vidurawarna/EN2090_Project_LPS/Images/Oscilloscope/2022_03_28/Note.txt

>> We implemented the circuit on a dot board to test high currents.
>> 1-1ohm means 1.1ohms in the video names
