vidurawarna/EN2090_Project_LPS/Documents/Block Level Designs-nifla.docx

Block Level Designs

The main blocks of a linear power supply are as follows,

We are given a 230V to 15V transformer the peak value of the secondary winding V_(PSec) is around 21.2V. We are using full-wave bridge rectification for the rectification. Here we should consider the Peak-Inverse-Voltage (PIV) of each diode. Since the reverse-biased voltage can go up to ( V_(pSec) -0.7)V (Here we assume forward biased voltage across a diode as 0.7V . Since it can vary, we should double-check diodes before assuming such voltages), the diodes we choose should have a PIV above 19.5V .

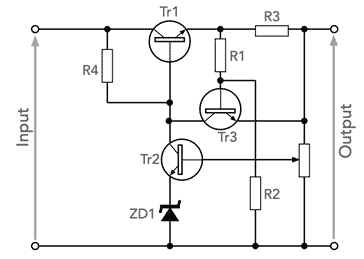
[picture p15: figure]

Next, we may use smoothing capacitors to smooth the voltage and reduce the ripple factor. Ripple voltage can be calculated from the following equation,

V_(ripple) =(I_(load))/(2fC)

Since we have a rectified voltage wave at this point, we can regulate it and get a good DC output at the load. We can consider the current limiting of the circuit here and have circuitry for regulation with current limiting as to the figure shows.

We can limit the maximum current by the equation,

I_(max) =1/(R_3)((1+(R_1)/(R_2))V_(BE) +(R_1)/(R_2)V_(reg)

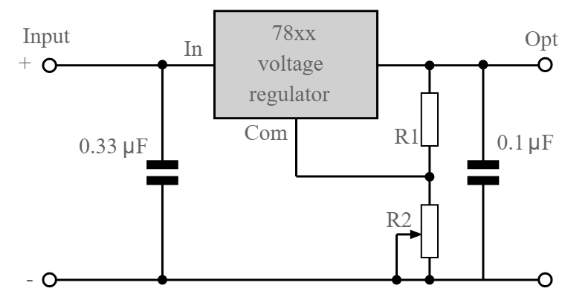
[picture p16: figure]

Since 78xx series voltage regulators are commonly used for voltage regulation, we can consider using them for the regulation as well. We can get variable voltage output from these ICs by just adding extra two resistors. The output voltage can be calculated by the equation,

V_(out) =V_(XX) +((V_(XX))/(R_1)+I_o )R_2

V_(XX) =voltage of the regulator, I_o =current in the common line
