vidurawarna/EN2090_Project_LPS/Documents/LPS project report/DS1.pdf

# DATASHEET LINEAR POWER SUPPLY

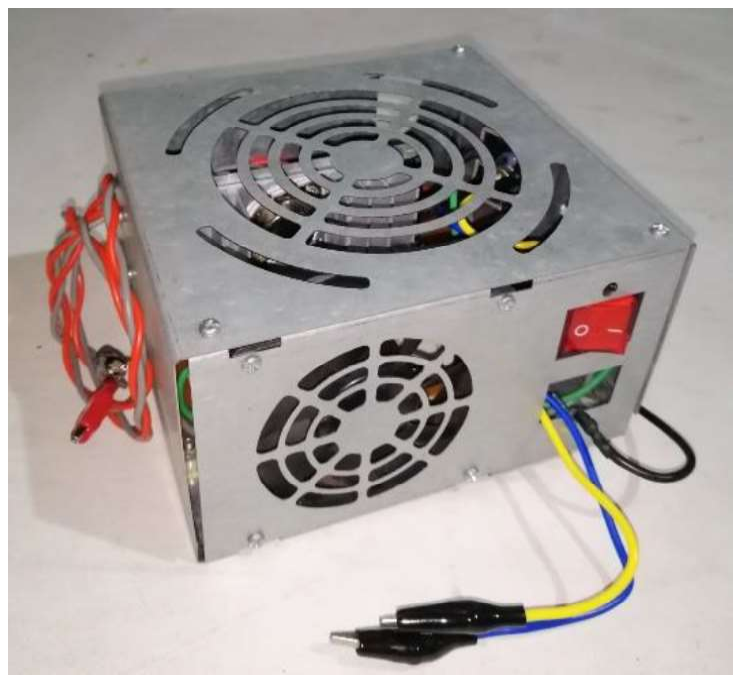
[picture p18: figure]
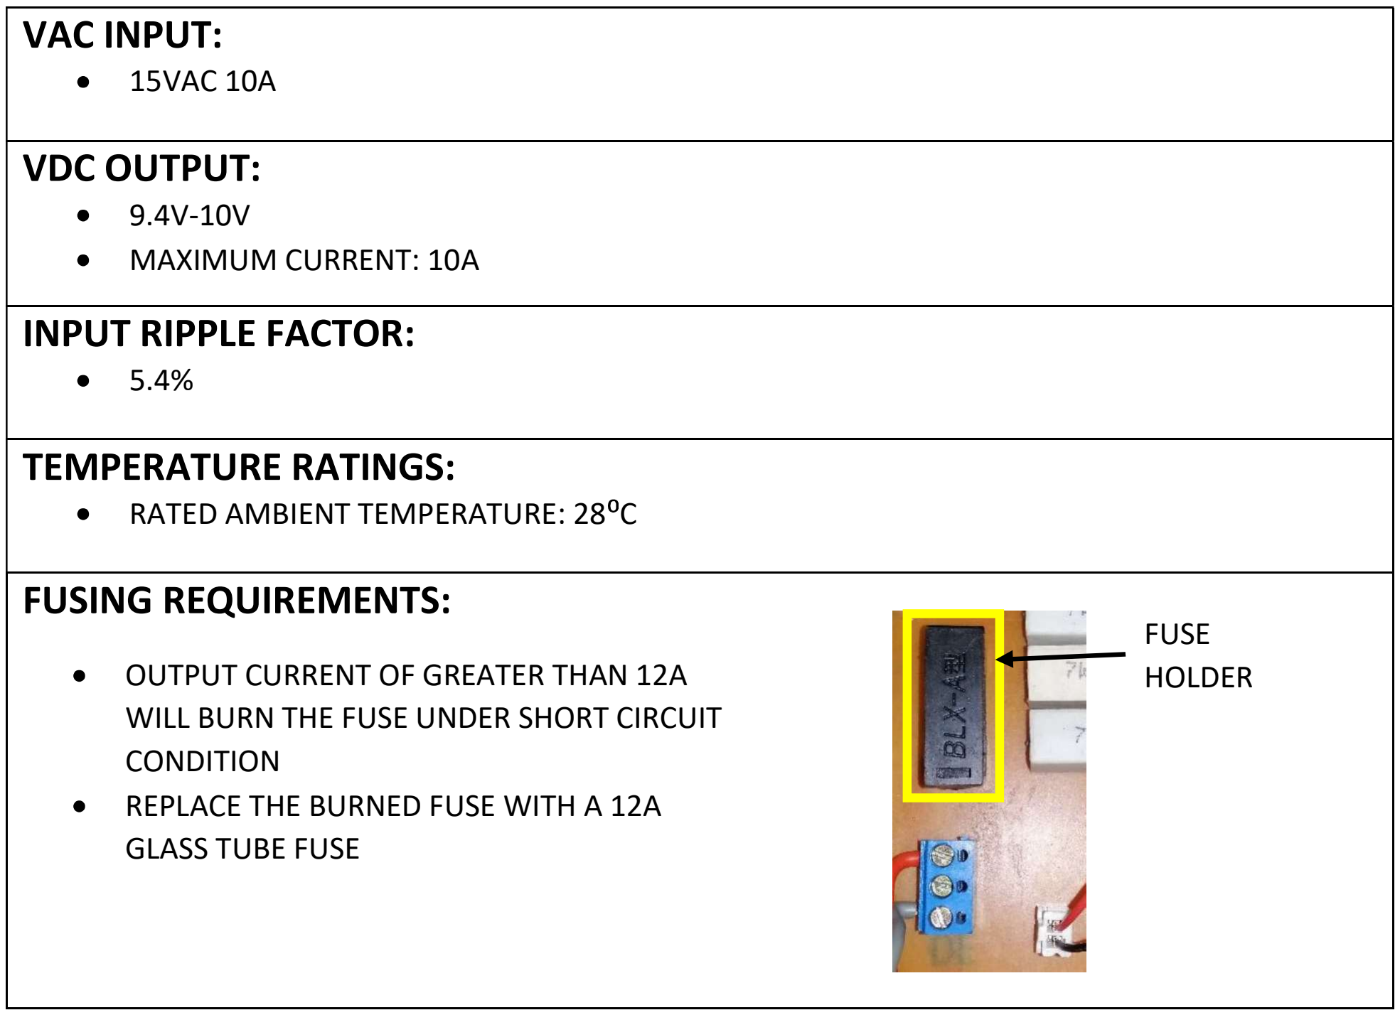
[picture p19: figure]
VAC INPUT: 15VAC 10A; VDC OUTPUT: 9.4V-10V MAXIMUM CURRENT: 10A INPUT RIPPLE FACTOR: 5.4%; TEMPERATURE RATINGS: RATED AMBIENT TEMPERATURE: 28 C; FUSING REQUIREMENTS:; OUTPUT CURRENT OF GREATER THAN 12A WILL BURN THE FUSE UNDER SHORT CIRCUIT CONDITION REPLACE THE BURNED FUSE WITH A 12A GLASS TUBE FUSE; FUSE HOLDER
