vidurawarna/EN2090_Project_LPS/Documents/Initial Submission.docx

Group members:

B.S.V.W. Munasinghe - 190397E - Leader

M.M.R.H. Munasinghe – 190399L

M.N.F. Nifla – 190413D

M.N.M. Nushath - 190423H

Choices:

1. Linear Power Supply
2. Analog line follower
3. Lux Meter

Reasons:

Every group member is interested in robotics. And some of the members have components with them to make a line following robot. Using digital techniques some of us have made line following robots. Everyone is interested to make this robot using only analog techniques.
