vidurawarna/EN2090_Project_LPS/Documents/LPS Calculations.pdf

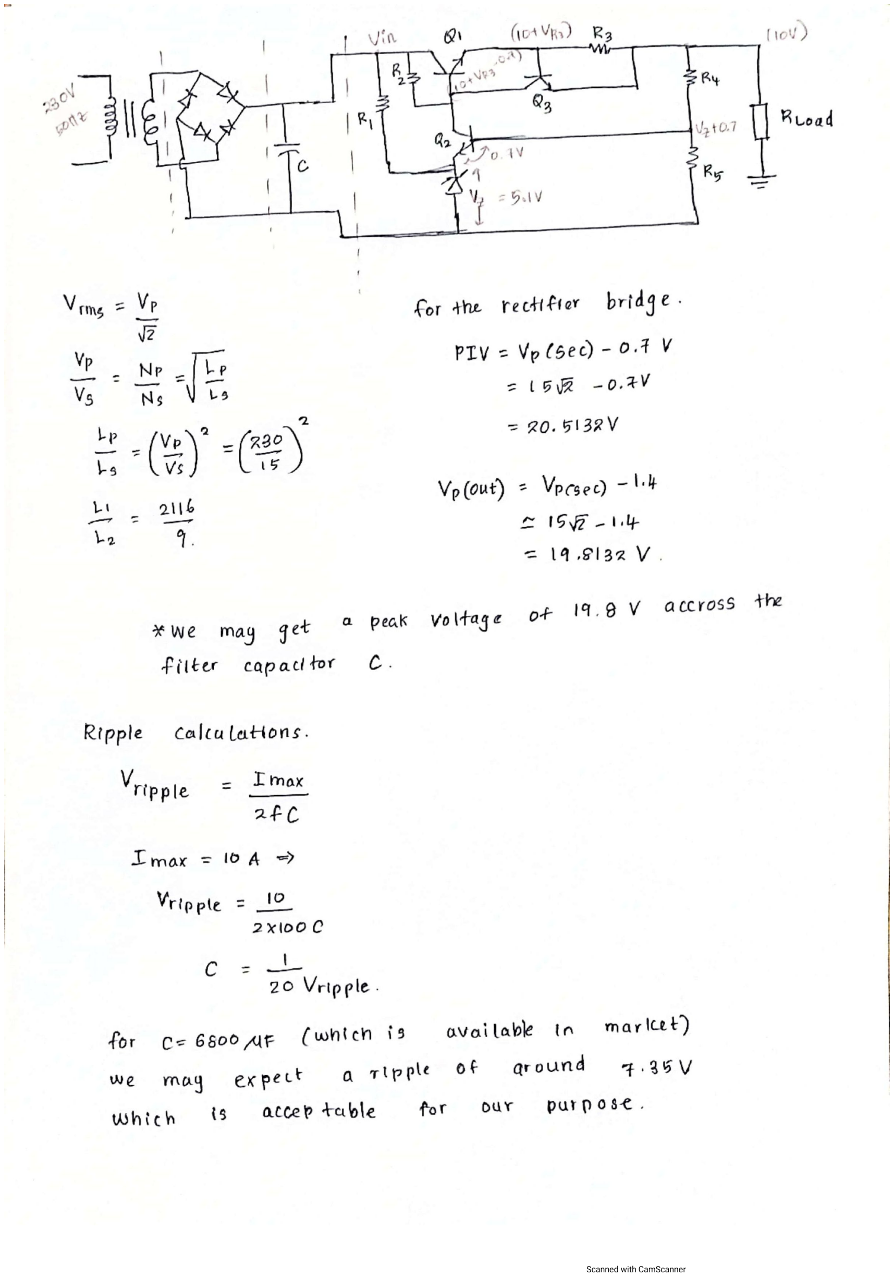
[picture p21: page 1]
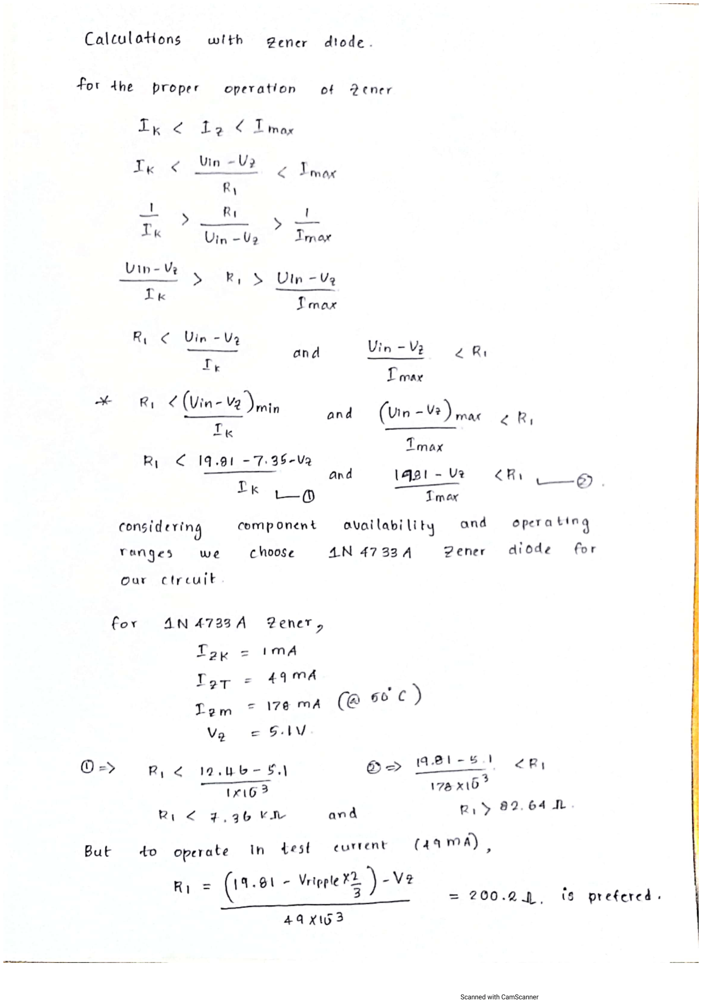
[picture p22: page 2]
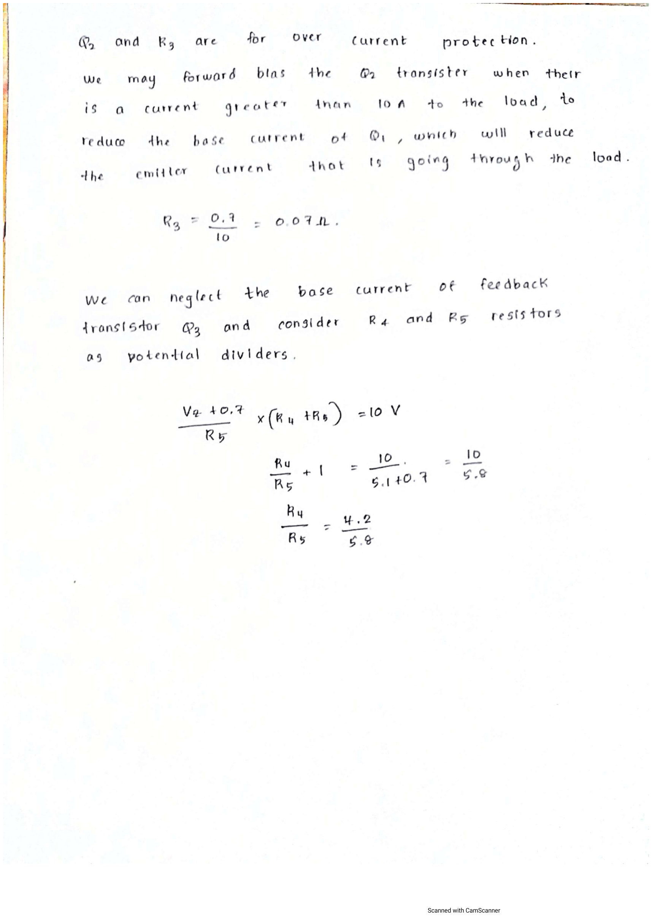
[picture p23: page 3]
