vidurawarna/EN2090_Project_LPS/Documents/LPS project report/enclosure photos/img 3.jpg

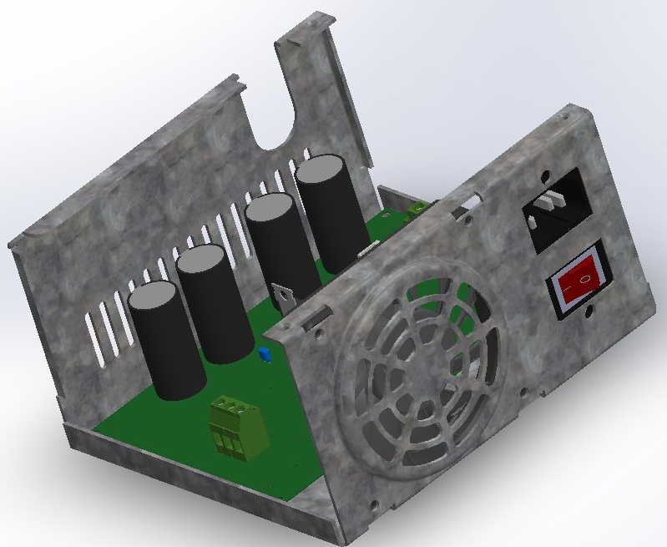
Documents/LPS project report/enclosure photos/img 3.jpg
