vidurawarna/EN2090_Project_LPS/Images/Bread board implementations/Home_1_IMG_20220316_000019.jpg

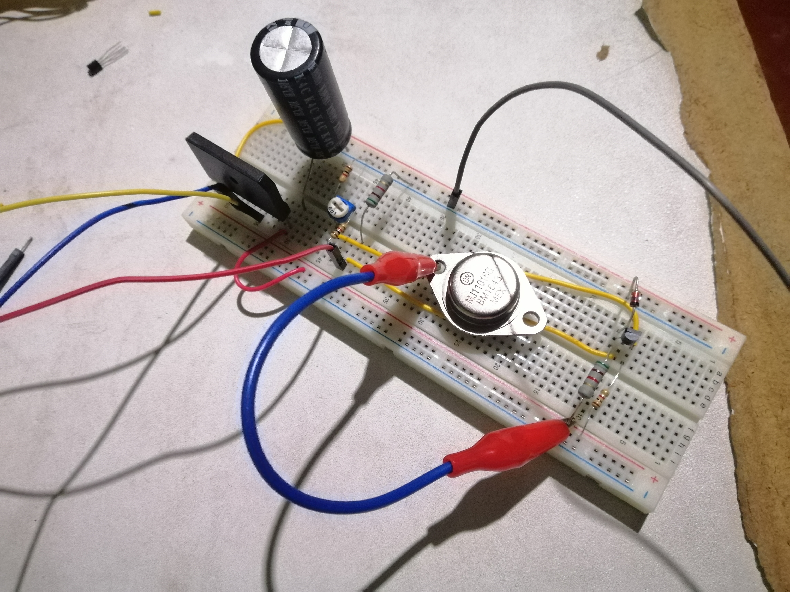
Images/Bread board implementations/Home_1_IMG_20220316_000019.jpg
