vidurawarna/EN2090_Project_LPS/Images/Bread board implementations/Lab_2_IMG_20220315_174703.jpg

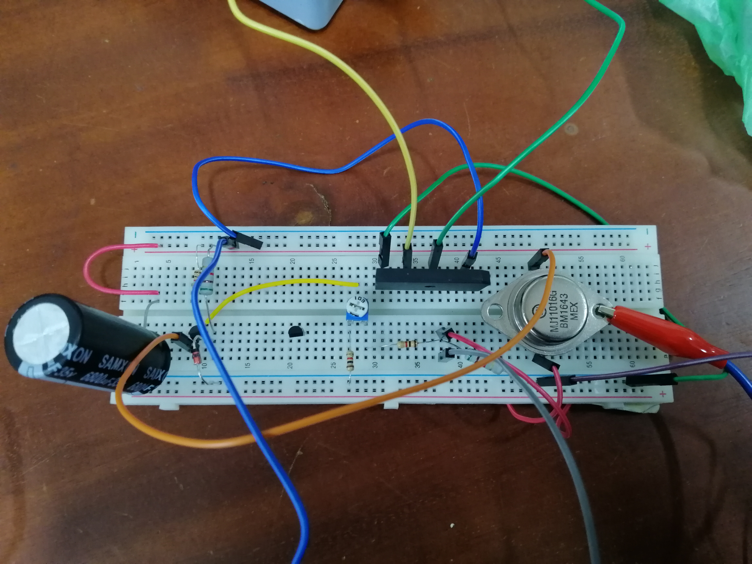
Images/Bread board implementations/Lab_2_IMG_20220315_174703.jpg
