vidurawarna/EN2090_Project_LPS/Images/Enclosure/1.png

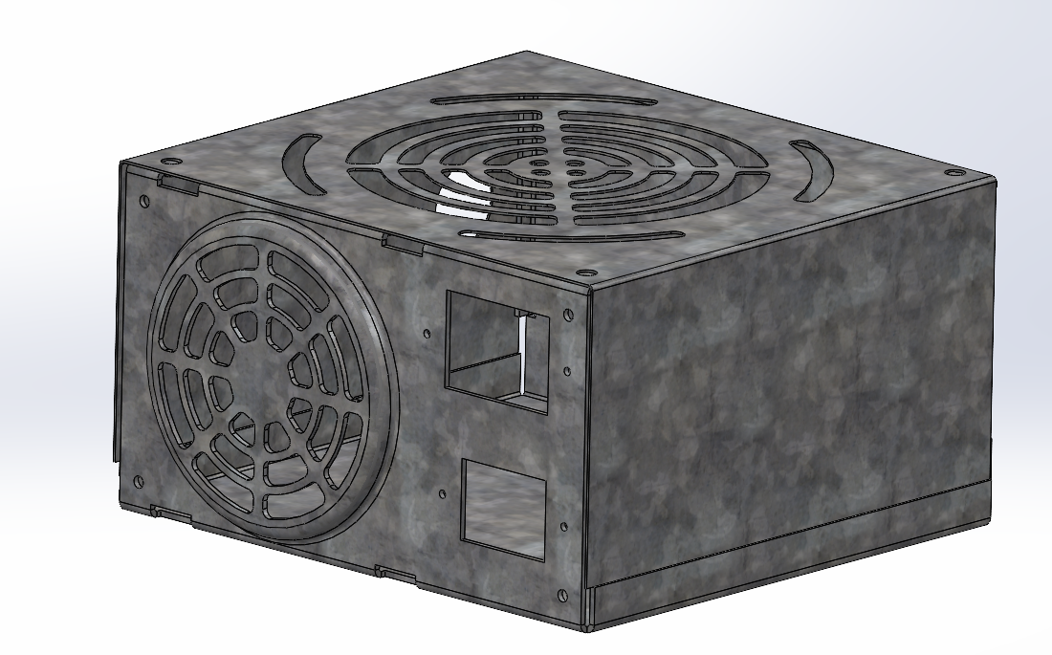
Images/Enclosure/1.png
