vidurawarna/EN2090_Project_LPS/Images/Enclosure/2.png

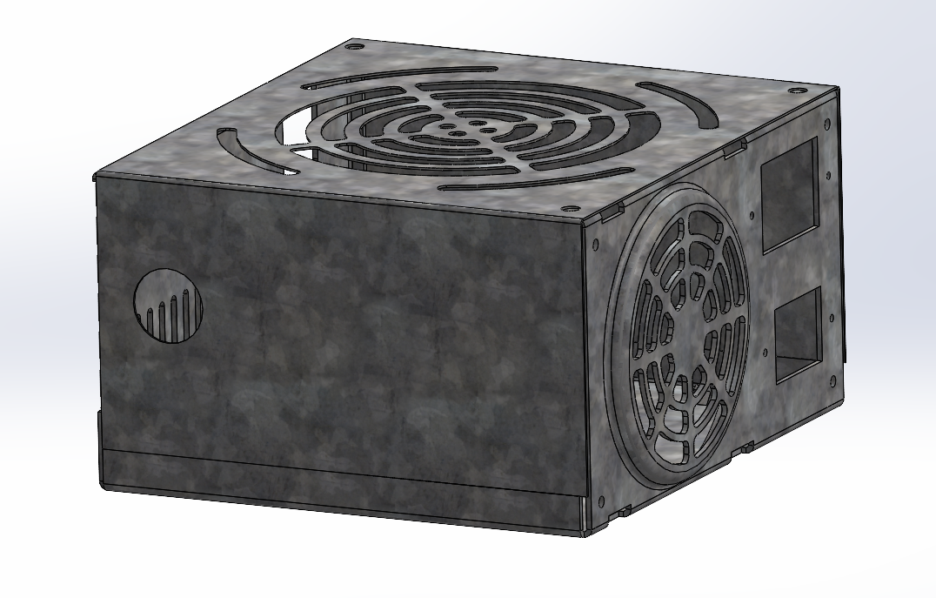
Images/Enclosure/2.png
