vidurawarna/EN2090_Project_LPS/Images/Enclosure/3.png

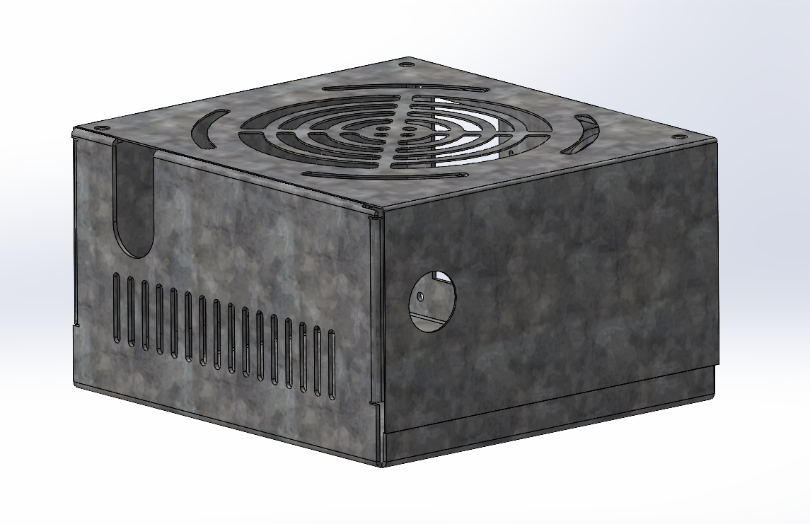
Images/Enclosure/3.png
