vidurawarna/EN2090_Project_LPS/Images/Enclosure/4.png

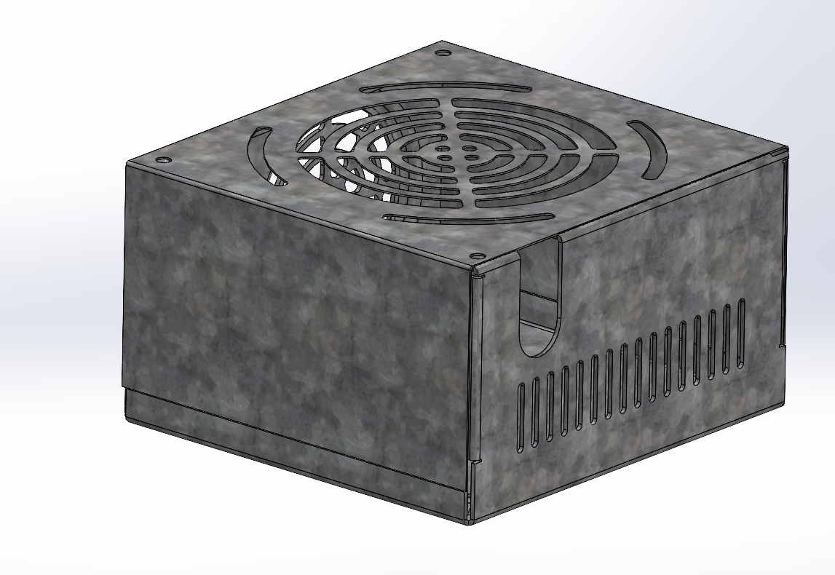
Images/Enclosure/4.png
