vidurawarna/EN2090_Project_LPS/Images/Final Product/IMG_20220722_162321.jpg

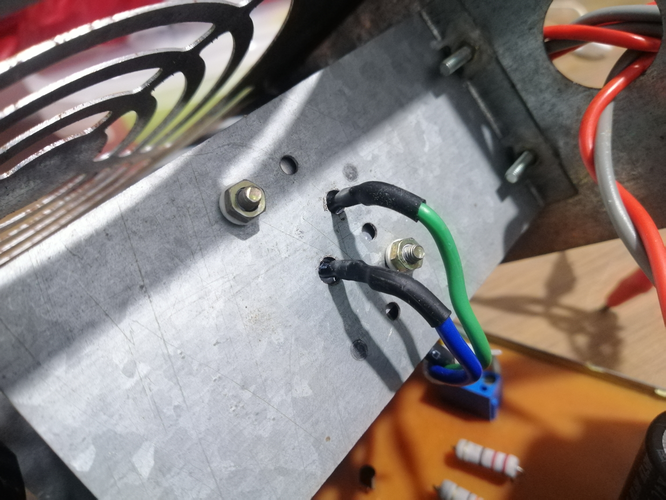
Images/Final Product/IMG_20220722_162321.jpg
