vidurawarna/EN2090_Project_LPS/Images/Final Product/IMG_20220722_162424.jpg

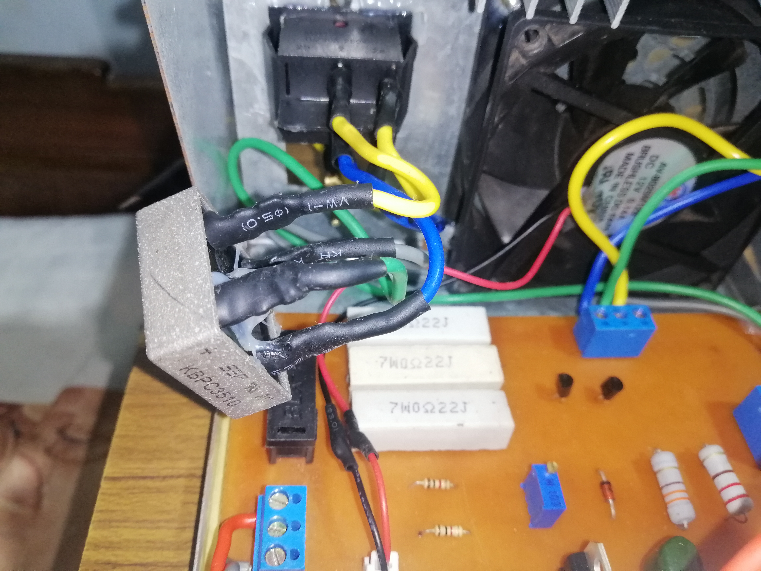
Images/Final Product/IMG_20220722_162424.jpg
