vidurawarna/EN2090_Project_LPS/Images/Oscilloscope/2022_03_15/Regulated_Output_10V_1_IMG_20220315_173458.jpg

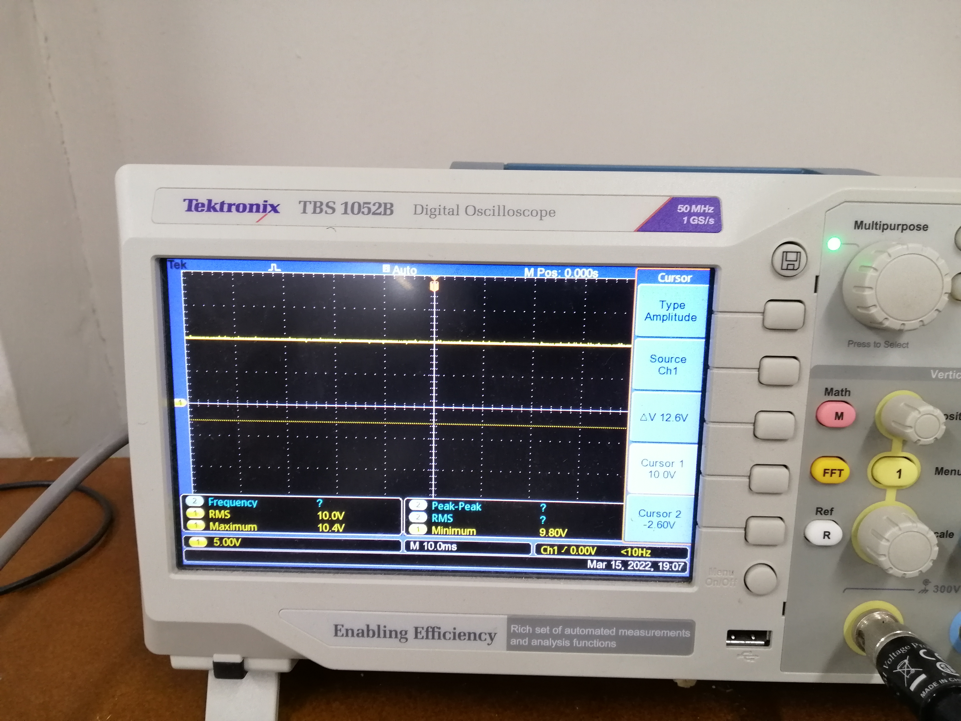
Images/Oscilloscope/2022_03_15/Regulated_Output_10V_1_IMG_20220315_173458.jpg
