vidurawarna/EN2090_Project_LPS/Images/Oscilloscope/2022_03_23/150ohm_load_IMG_20220323_174511.jpg

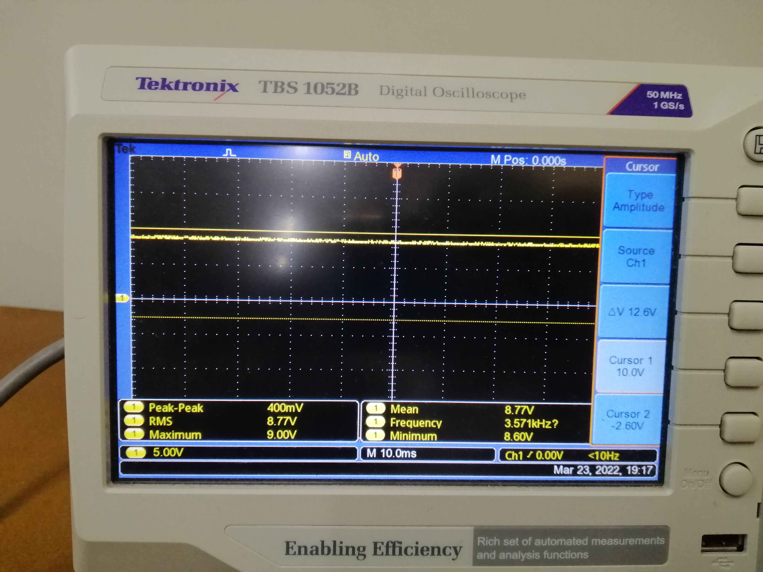
Images/Oscilloscope/2022_03_23/150ohm_load_IMG_20220323_174511.jpg
