vidurawarna/EN2090_Project_LPS/Images/Oscilloscope/2022_03_28/IMG_20220328_165636_load_resistance.jpg

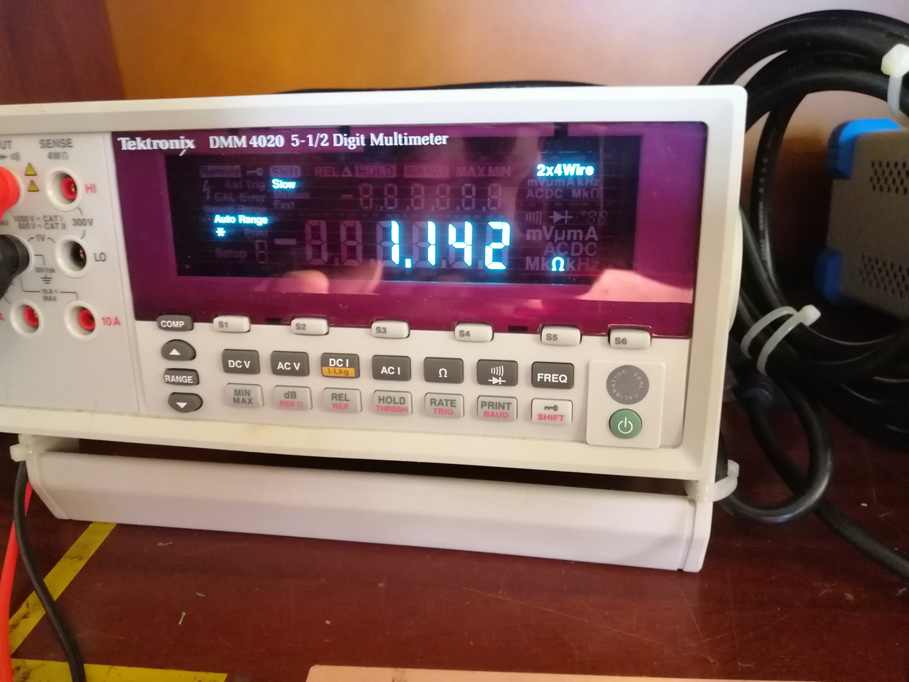
Images/Oscilloscope/2022_03_28/IMG_20220328_165636_load_resistance.jpg
