vidurawarna/EN2090_Project_LPS/Documents/LPS project report/components.png

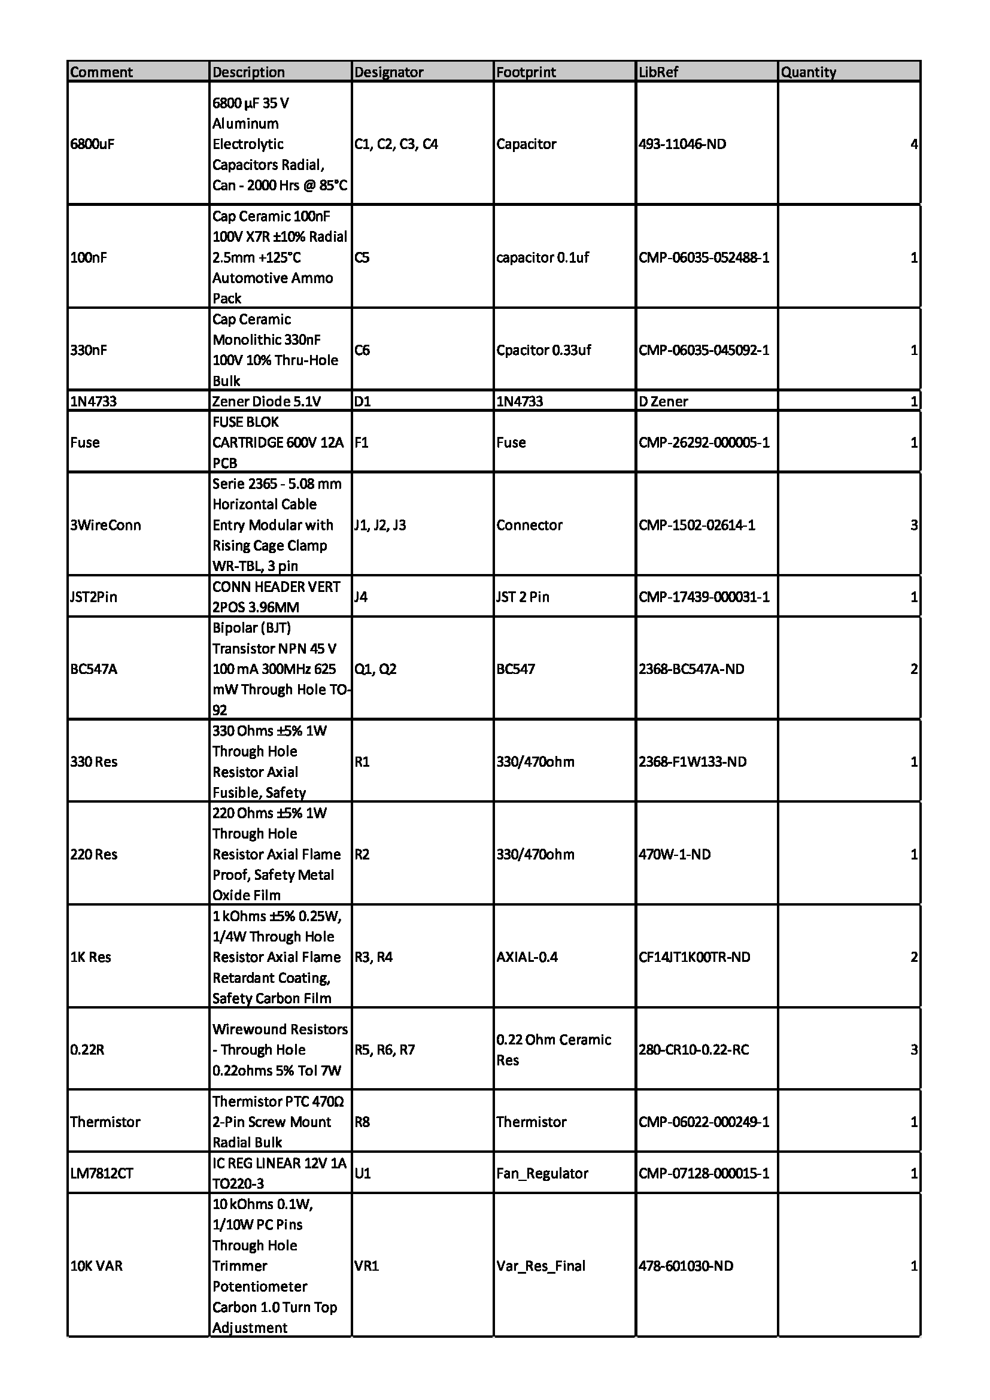
Documents/LPS project report/components.png
