vidurawarna/EN2090_Project_LPS/Enclosure design/final assambly/Assem1.SLDASM

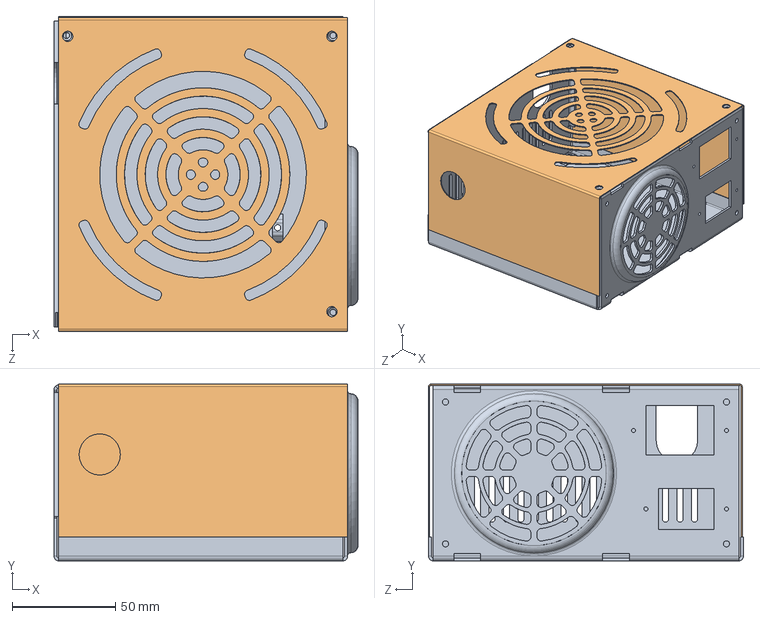
[picture p47: CAD file, 2022-03-17]
Enclosure design/final assambly/Assem1.SLDASM
147.1 x 85.5 x 152.5 mm
chassis1
chassis2 edited2
