vidurawarna/EN2090_Project_LPS/Enclosure design/forming tools/punchur.SLDPRT

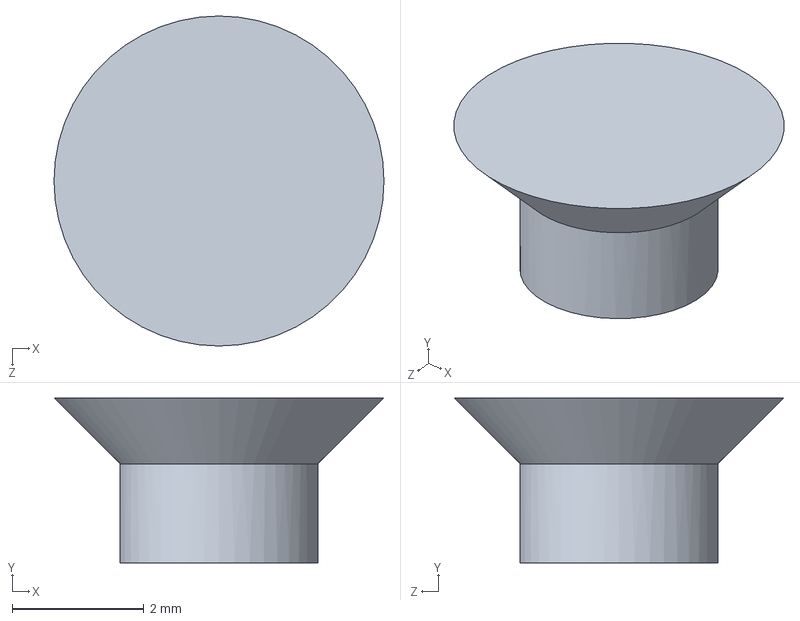
[picture p48: CAD file, 2022-03-17]
Enclosure design/forming tools/punchur.SLDPRT
5.00 x 2.50 x 5.00 mm
