vidurawarna/EN2090_Project_LPS/Enclosure design/parts/chassis2 edited2.SLDPRT

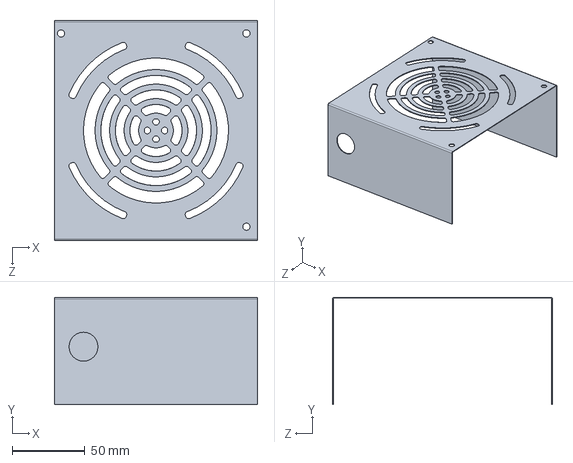
[picture p49: CAD file, 2022-03-17]
Enclosure design/parts/chassis2 edited2.SLDPRT
140.0 x 74.0 x 151.9 mm
