vidurawarna/EN2090_Project_LPS/Enclosure design/forming tools/Part2.SLDPRT

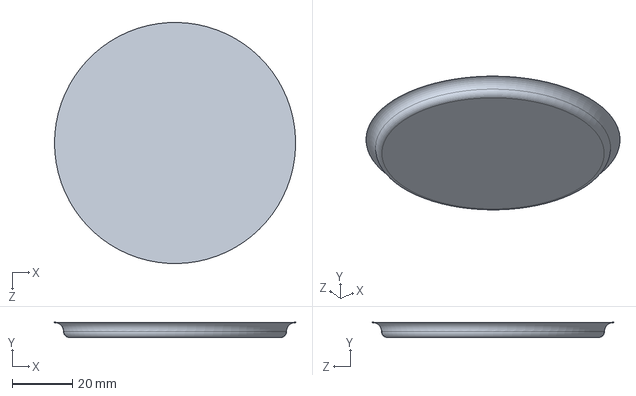
[picture p50: CAD file, 2022-03-17]
Enclosure design/forming tools/Part2.SLDPRT
80.0 x 5.00 x 80.0 mm
