vidurawarna/EN2090_Project_LPS/Enclosure design/parts/chassis1.SLDPRT

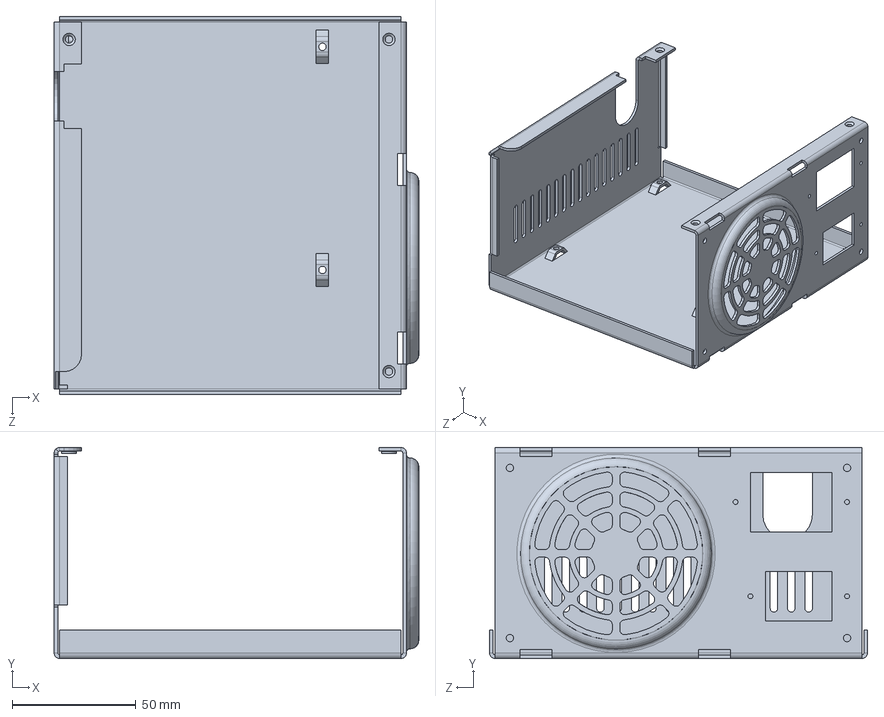
[picture p51: CAD file, 2022-03-17]
Enclosure design/parts/chassis1.SLDPRT
147.1 x 85.1 x 152.5 mm
