vidurawarna/EN2090_Project_LPS/Enclosure design/forming tools/Part1.SLDPRT

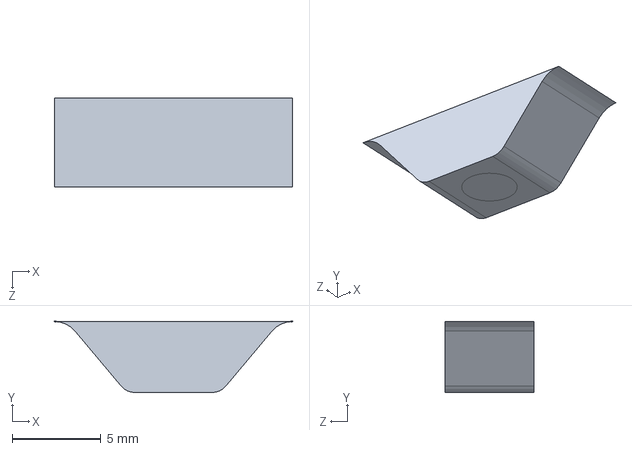
[picture p52: CAD file, 2022-03-17]
Enclosure design/forming tools/Part1.SLDPRT
13.4 x 4.00 x 5.00 mm
