vidurawarna/EN2090_Project_LPS/Documents/LPS project report/DS2.pdf

### SHORT CIRCUIT PROTECTION:

### OVERLOAD PROTECTION:

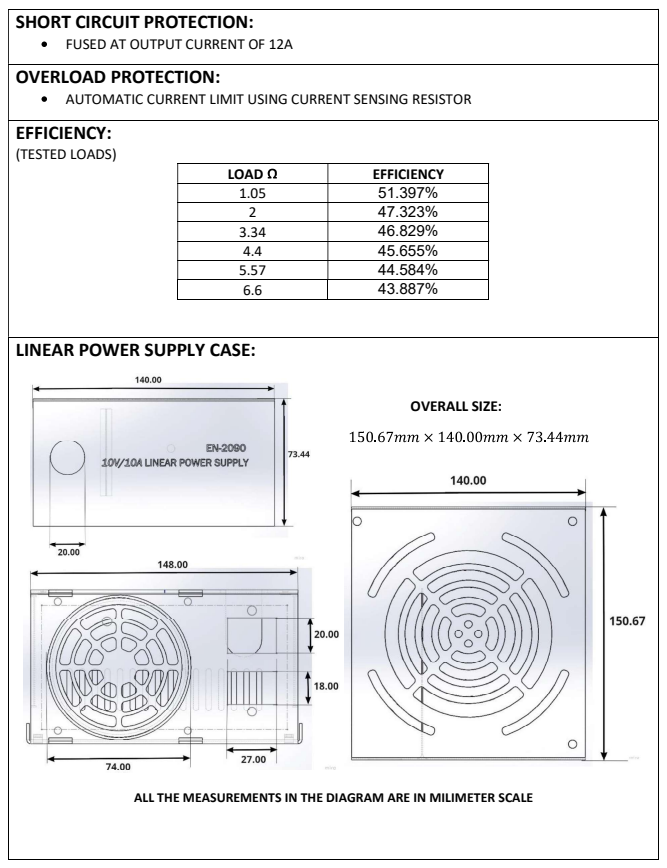
[picture p57: page 1]
OVERALL SIZE:

FUSED AT OUTPUT CURRENT OF 12A

AUTOMATIC CURRENT LIMIT USING CURRENT SENSING RESISTOR
EFFICIENCY:
(TESTED LOADS)

LOAD | EFFICIENCY
1.05 51.397%
2 47.323%
3.34 46.829%
4.4 45.655%
5.57 44.584%
6.6 43.887%

LINEAR POWER SUPPLY CASE:

ALL THE MEASUREMENTS IN THE DIAGRAM ARE IN MILIMETER SCALE
