vidurawarna/EN2090_Project_LPS/PCB Design/For Nilambara.pdf

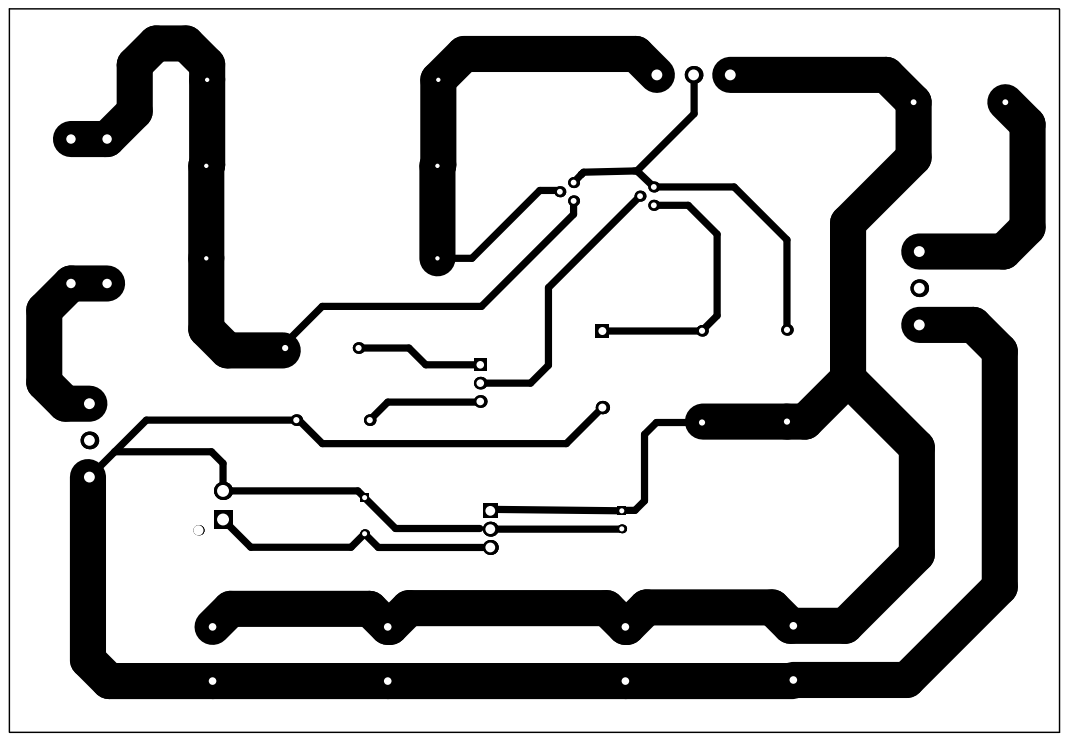
[picture p58: page 1]

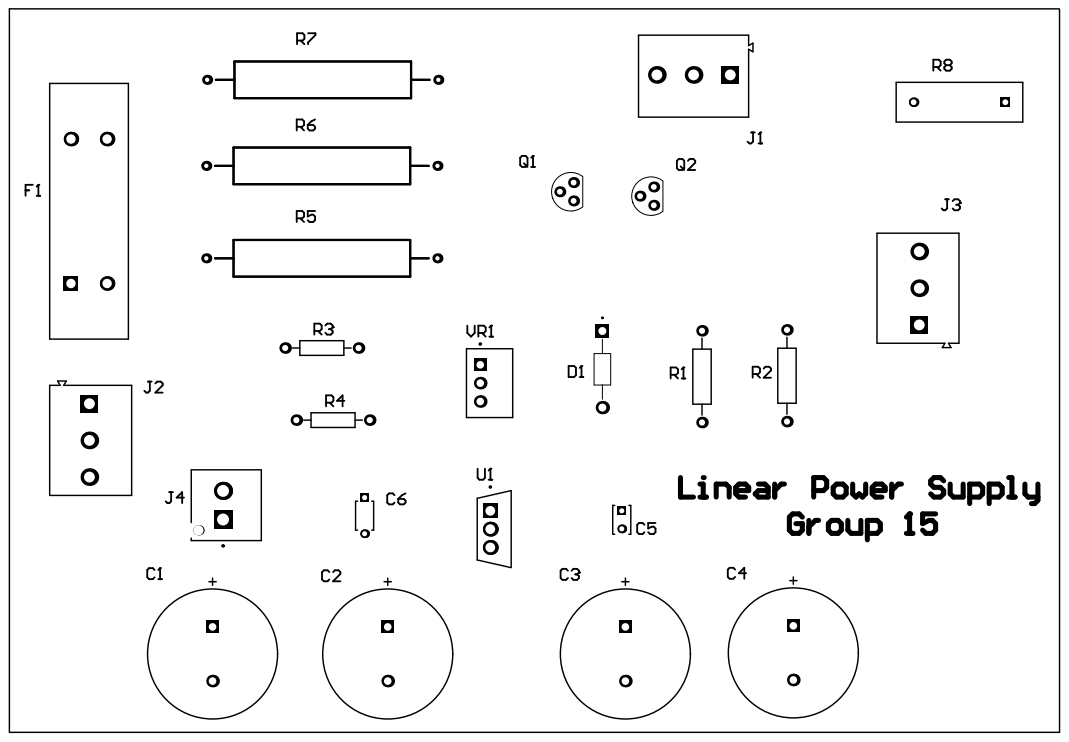
[picture p59: page 2]
