vidurawarna/EN2090_Project_LPS/PCB Design/For Nilambara_ Mirorred.pdf

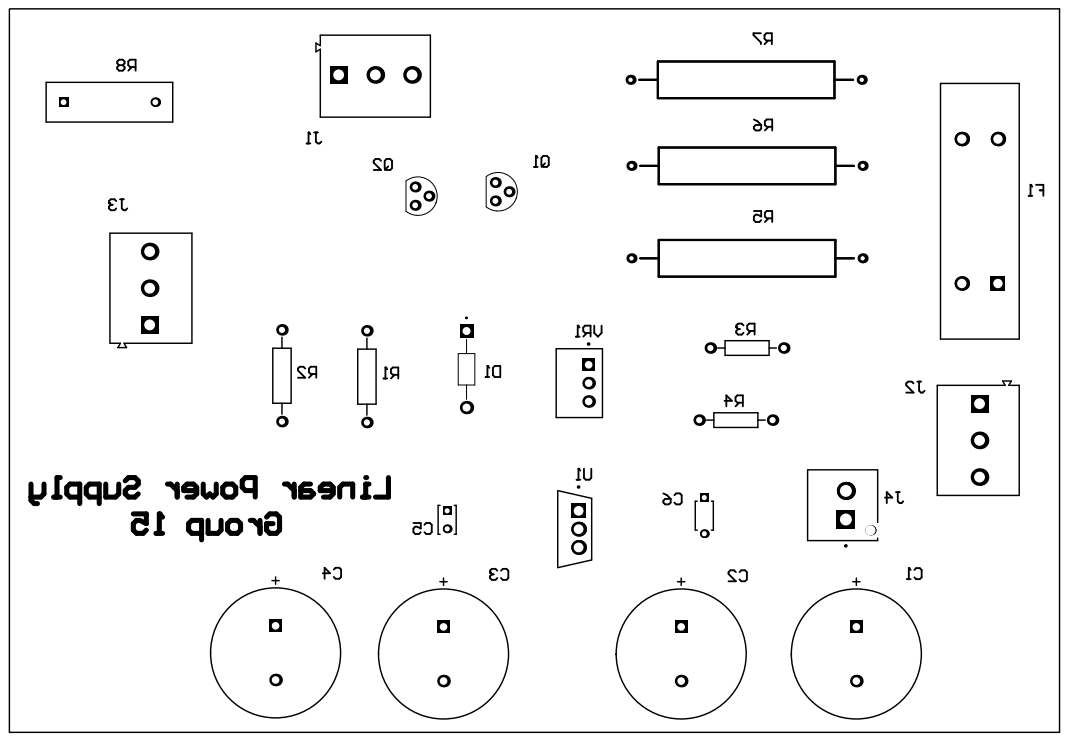
[picture p60: page 2]
