vidurawarna/EN2090_Project_LPS/Documents/LPS project report/qq2.pdf

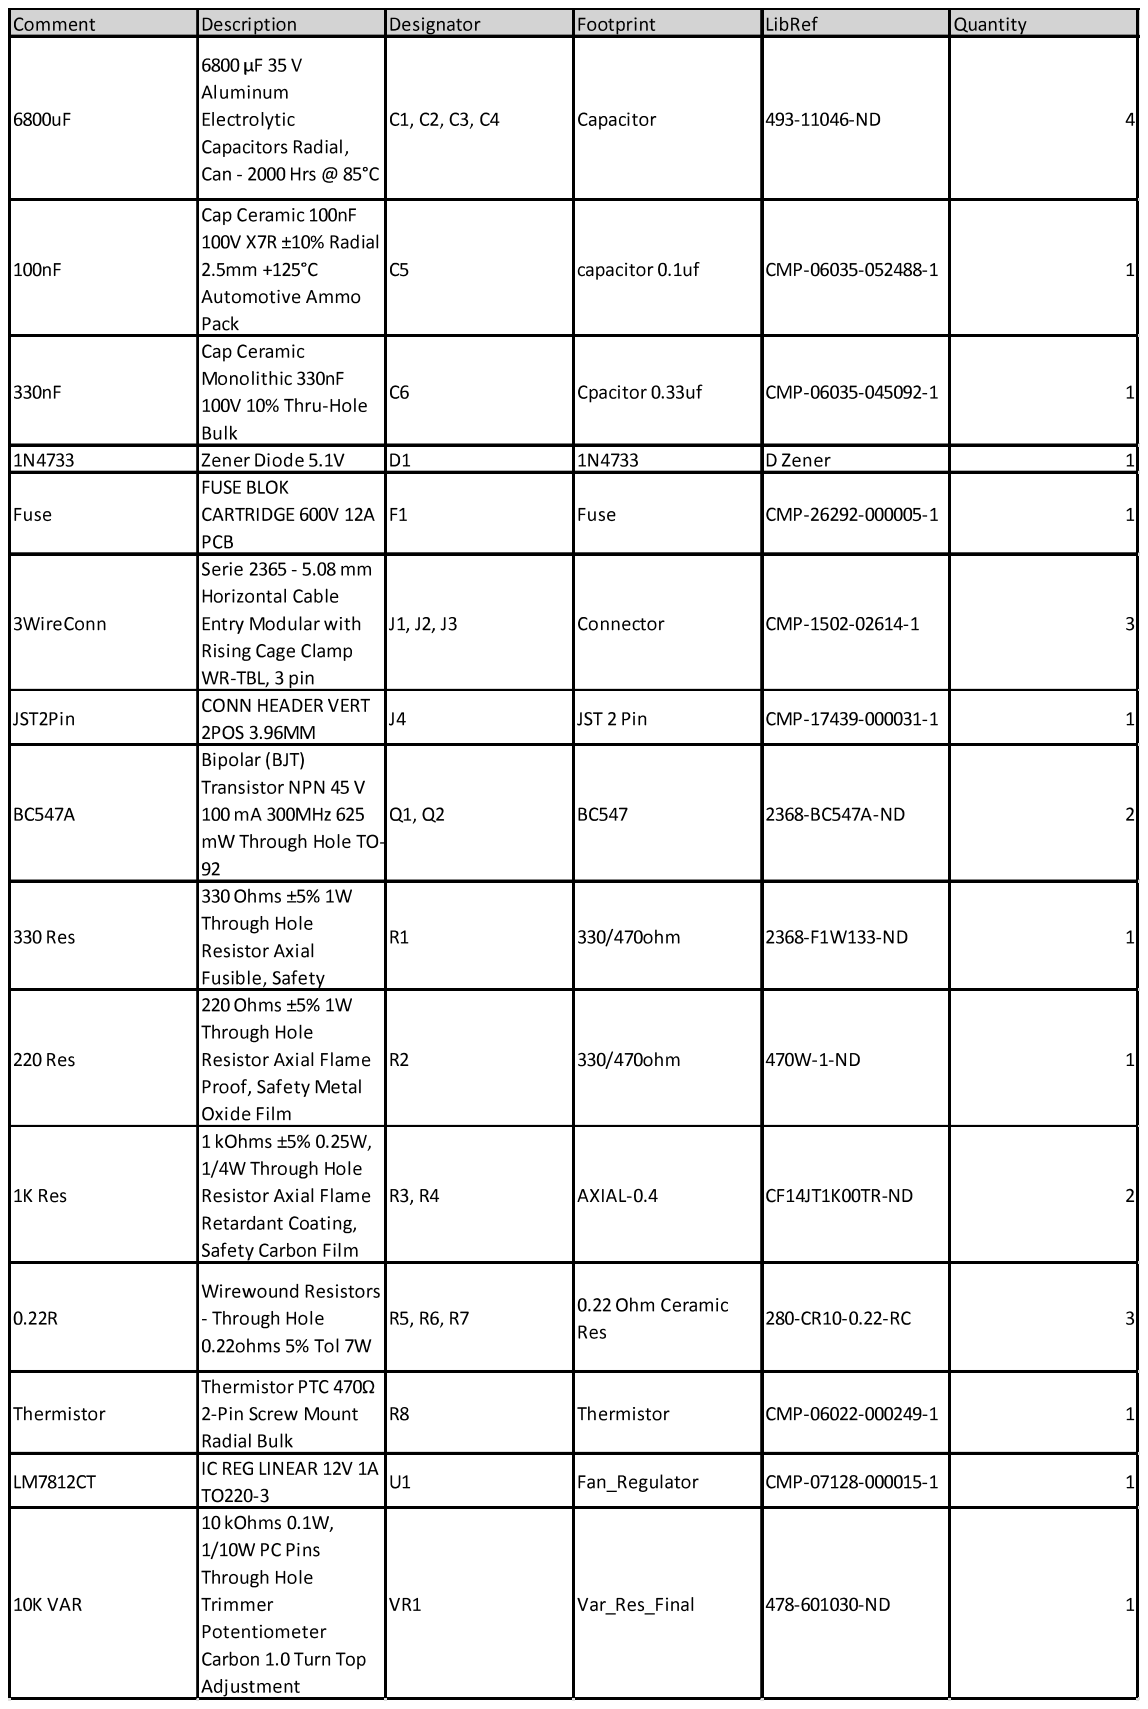
[picture p61: page 1]
