vidurawarna/EN2090_Project_LPS/Documents/LPS project report/schematic.pdf

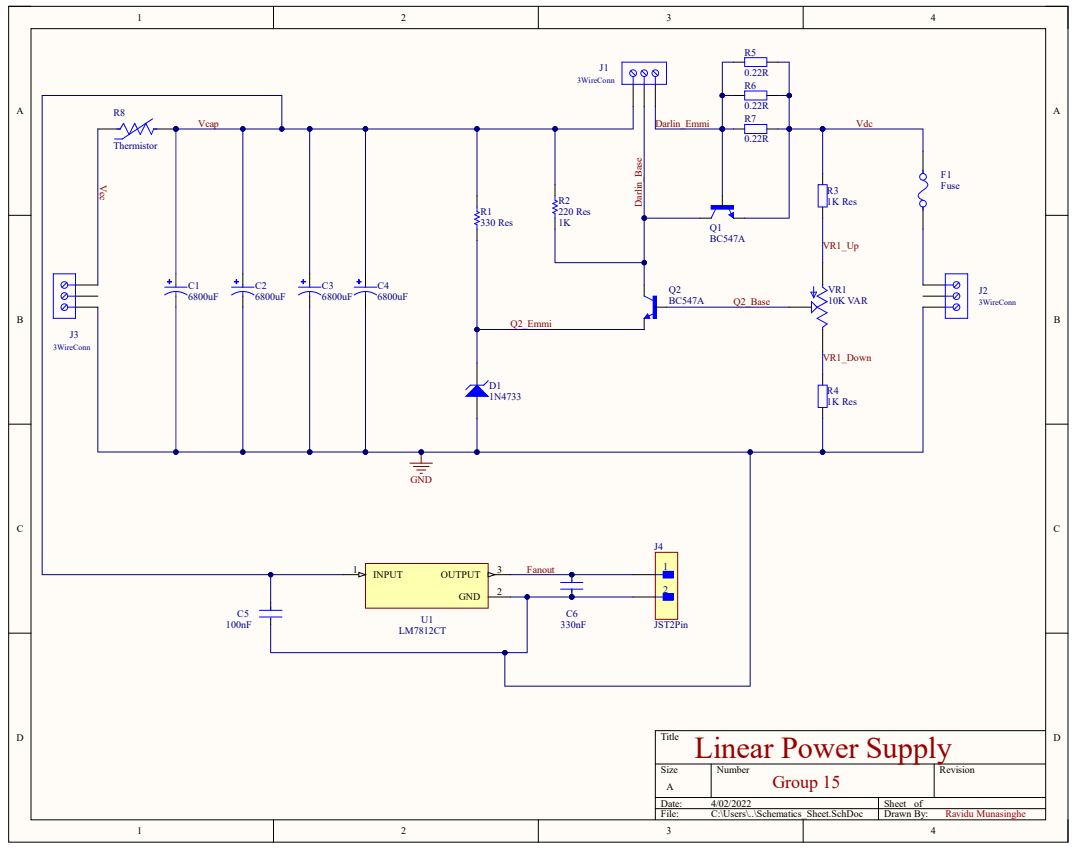
[picture p62: page 1]
