vidurawarna/EN2090_Project_LPS/Simulations/LTSpice/LPS_with_current_limitter/with_current_limitter.asc

C1: cap; 6800µF
C2: cap; 6800µF
C3: cap; 6800µF
C4: cap; 6800µF
D2: zener; 1N4733
D7: diode
D8: diode
D9: diode
D10: diode
L3: ind2; 2116mH; Rser=0.001
L4: ind2; 9mH
Q1: npn; Qbc547b
Q2: npn; Qbc547b
Q4: npn; mj11016g
R1: res; 330
R2: res; 0.22
R3: res; 0.22
R4: res; 1
R5: res; 220
R6: res; 0.22
R7: res; 710
R8: res; 1k
V1: voltage; SINE(0 325.26 50)
Named nets: 0, Vout, Vc
K L3 L4 1
.include SPICES.txt
.include MJ11016.LIB
.include BC547B.LIB
.tran 0 0.1 0ms
