vidurawarna/EN2090_Project_LPS/Simulations/LTSpice/LPS/Basic Sketch 1.asc

C3: cap; 13600µF
D2: zener; 1N4733
D7: diode
D8: diode
D9: diode
D10: diode
L3: ind2; 2116mH; Rser=0.001
L4: ind2; 9mH
LOAD: res; 1
Q1: npn; Qbc547b
Q4: npn; mj11016g
R1: res; 330
R5: res; 470
R7: res; 410
R8: res; 570
V1: voltage; SINE(0 325.26 50)
Named nets: 0, Vout, Vc
K L3 L4 1
.include SPICES.txt
.include MJ11016.LIB
.include BC547B.LIB
.tran 0.02
