vidurawarna/EN2090_Project_LPS/(list of files, drawings)

Other design files:
PCB Design/Sem3_Lab_PCB_Project/PCB.PcbDoc
PCB Design/Sem3_Lab_PCB_Project/PCB_Library.PcbLib
PCB Design/Sem3_Lab_PCB_Project/Schematics.SchLib
PCB Design/Sem3_Lab_PCB_Project/Schematics_Sheet.SchDoc
PCB Design/Sem3_Lab_PCB_Project/Sem3_Lab_PCB_Project.PrjPcb
Simulations/Proteus/LPS 12V/LPS_12.pdsprj
Simulations/Proteus/LPS 12V/Project Backups/LPS_12 [20220311, 18-01-36].pdsprj
Simulations/Proteus/LPS 12V/Project Backups/LPS_12 [20220311, 23-20-31].pdsprj
Simulations/Proteus/LPS 12V/Project Backups/LPS_12 [20220312, 10-02-56].pdsprj
Simulations/Proteus/LPS 12V/Project Backups/LPS_12 [20220312, 18-38-19].pdsprj
Simulations/Proteus/LPS 12V/Project Backups/LPS_12 [20220315, 12-19-09].pdsprj
Simulations/Proteus/LPS/LPS.pdsprj
Simulations/Proteus/Protection Circuit/New Project.pdsprj
Simulations/Proteus/Protection Circuit/Project Backups/New Project [Proteus 8.9].pdsprj
Simulations/Proteus/Protection Circuit/Project Backups/test1 [20220307, 18-56-57].pdsprj
