vidurawarna/EN2090_Project_LPS/(commit log)

2022-03-16 Repo for lab project is initialized
    [LPS.pdsprj, LPS_12 [20220311, 18-01-36].pdsprj, LPS_12 [20220311, 23-20-31].pdsprj, LPS_12 [20220312, 10-02-56].pdsprj, LPS_12 [20220312, 18-38-19].pdsprj, LPS_12 [20220315, 12-19-09].pdsprj, LPS_12.pdsprj, New Project [Proteus 8.9].pdsprj]
2022-03-17 solid work files(final assamnly, parts and forming tools)
    [Assem1.SLDASM, Part1.SLDPRT, Part2.SLDPRT, chassis1.SLDPRT, chassis2 edited2.SLDPRT, punchur.SLDPRT]
2022-03-17 Simulations modified,Images added
    [test1.pdsprj]
2022-03-17 zener resistor changed
2022-03-24 current limitter cct modified
